bhall66/NTP-clock/README.md

# NTP clock
 
This is a dual-display NTP clock using an ESP32 microcontroller and an ILI9341 TFT display.  See w8bh.net for details and step-by-step explanation.
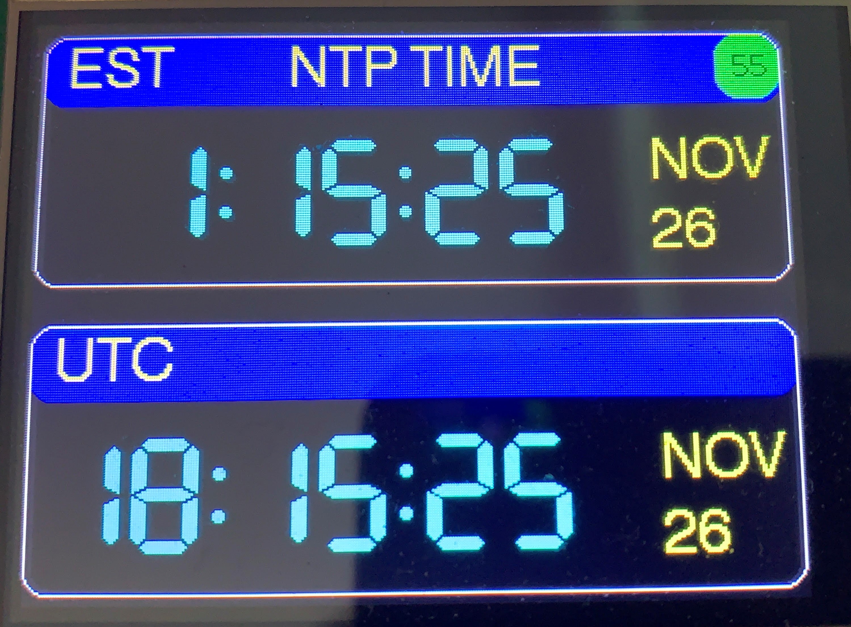
[picture p1: ntp_clock.jpg]
