bhall66/NTP-clock/PCB/BN32/BN32 layout.jpg

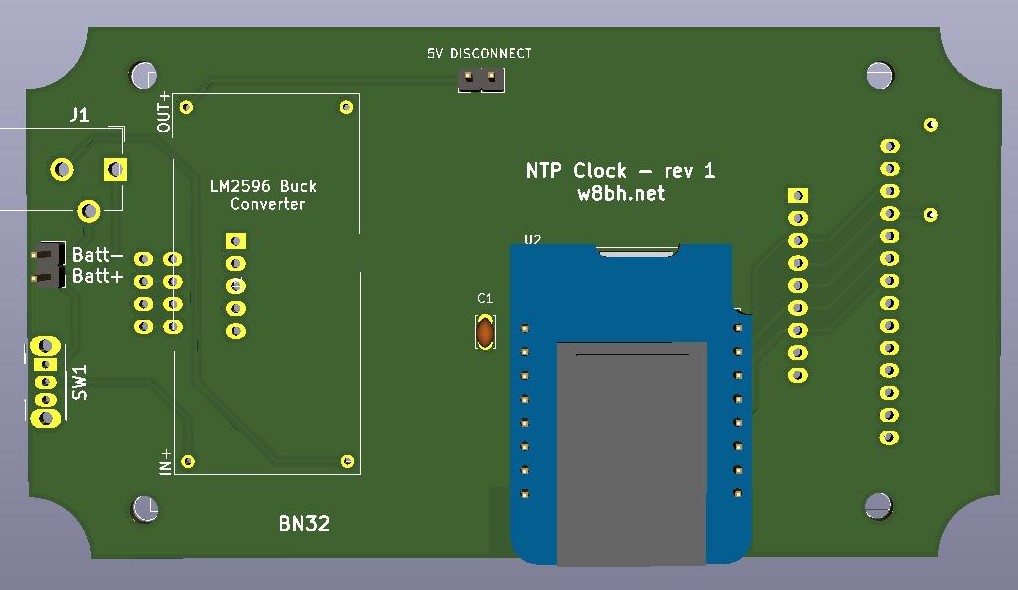
PCB/BN32/BN32 layout.jpg
