bhall66/NTP-clock/PCB/BN33/BN33 layout.jpg

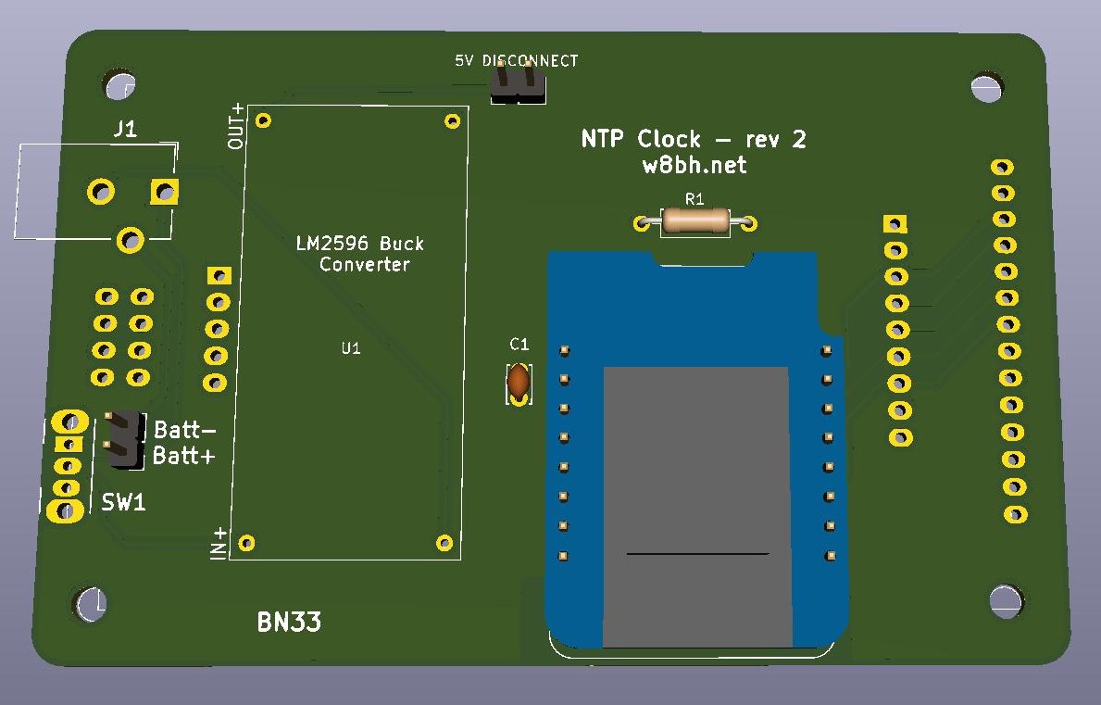
PCB/BN33/BN33 layout.jpg
