bhall66/NTP-clock/(threads)

Thread 1 (2024-03-27):

ILI9488

sp9rqa, 2024-03-27:
I can't get the ILI9488 480x320 display to work. The image appears for a second and then disappears and then there is just a white screen.
The clock on the serial console works normally during this time.

#define TFT_MISO 19
#define TFT_MOSI 23
#define TFT_SCLK 18
#define TFT_CS   15  // Chip select control pin
#define TFT_DC    2  // Data Command control pin
#define TFT_RST   4  // Reset pin (could connect to RST pin)
#define TFT_WIDTH  480
#define TFT_HEIGHT 320

https://pl.aliexpress.com/item/1005006374487894.html
The sample programs work fine.

PSE help ;-)

bhall66, 2024-03-27:
Please use a supported display, which is ILI9341-based and 320x240 pixels
in size.   Refer to my project notes for more details.

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

sp9rqa, 2024-03-27:
On ILI9341 I have the same effect on this board, while ILI9341 works correctly for me on NodeMCU v1.1(38 pin).

sp9rqa, 2024-03-27:
OK. Problem solved. The LED is defined on the same port as the DC.
