bhall66/NTP-clock/(commit log)

2020-12-01 fix for missing date display
    Under certain circumstances, the date would not display, especially if the local time zone is ahead of UTC.
    The fix is provided by John WA2FZW. Thanks, John.
    [NTP_DualClock.ino]
2020-12-16 added pcb files
    These PCB gerbers are designed and provided by John Price WA2FZW
2021-02-06 added pcb gerbers
2021-02-06 added ESP8266 support
    Added support for ESP32 and ESP8266 boards. In addition, added a diagnostic LED display to help troubleshooting.
2021-02-07 Added day-above-month option
    By default, the date displays below the month, which looks normal in countries using the MDY date format. This option reverses the order, so that the day displays above the month.
    [NTP_DualClock.ino]
